manoloaterol/18650_Manager/schematics/18650_Manager_schematic.pdf

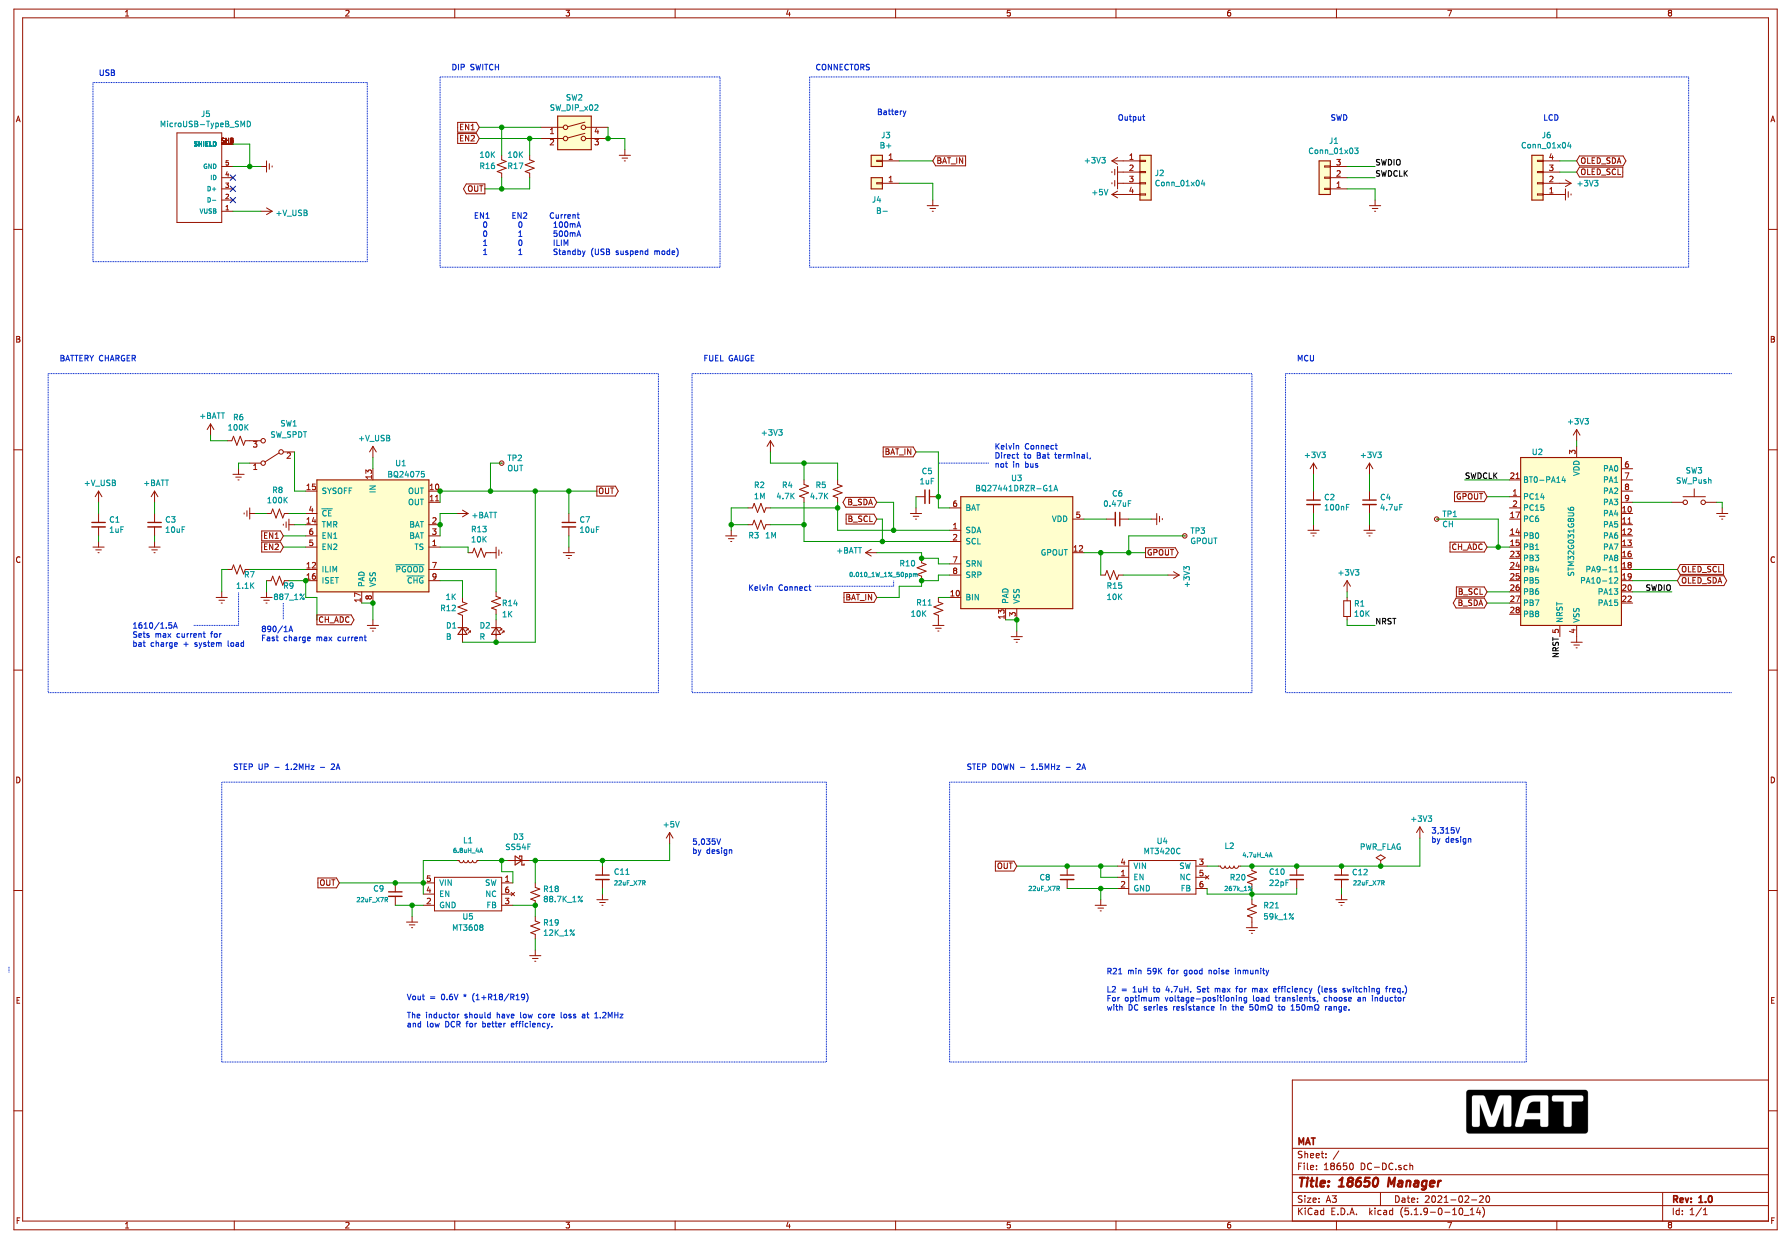
[picture p2: page 1]
