manoloaterol/18650_Manager/(threads)

Thread 1 (2023-07-21):

not an issue but a question i2c api

clecle253, 2023-07-21:
helo i order two of this board and i have a question i would like to use them to power up an esp32 or esp866 for domotic (home assistant) and i would get value display on screen on i2c to be able to serve this data on my dash board. is there an easy way to do that ?

manoloaterol, 2023-07-21:
Hi @clecle253. Thank you very much for your order.

The board and firmware are not ready to do what you want out-of-the-box, but you can make some modifications to achieve it. Not too easy way, but definitely possible.

On PCB, the only exposed MCU pins are the ones used to the display, so you can use them to communicate with ESP with the same protocol (I2C).

These are the steps to follow:

- Connect ESP MCU to the SCL and SDA pins reserved for the display. (if ESP is powered by the 18650_manager, both grounds are already common)
- ESP must be configured as I2C slave. If you are using ESP-IDF you can find a sample [here](https://github.com/espressif/esp-idf/tree/master/examples/peripherals/i2c/i2c_self_test). If you are programming in Arduino I'm pretty sure you can find some samples somewhere.
- Modify the 18650_Manager firmware to make a second I2C communication to send the data to your ESP.
- Send data to Home Assistant. Here you can create a custom sensor for ESPHome like [this](https://community.home-assistant.io/t/esphome-custom-sensor-bq27441/483177), or using the MQTT protocol.

Hope it helps.

clecle253, 2023-07-22:
Ok i'm not familiar with the ide and framework you use but il Will try to implement this feature cleanly if it work Well i Will make à pull request
