manoloaterol/18650_Manager/src/18650_DC-DC/Src/main.c

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
/* Includes ------------------------------------------------------------------*/
#include "main.h"

/* USER CODE BEGIN Includes */
#include "bq27441/bq27441-g1.h"
#include "bq27441/i2c.h"

#include "ssd1306/ssd1306.h"
#include <stdio.h>
/* USER CODE END Includes */

ADC_HandleTypeDef hadc1;

I2C_HandleTypeDef hi2c1;
I2C_HandleTypeDef hi2c2;

/* USER CODE BEGIN PV */
bq27441_g1_t bq27441_g1;

uint8_t mode = 1;      // visualization mode
uint32_t lastTick = 0; // used to avoid button bounce effect
/* USER CODE END PV */

void SystemClock_Config(void);
static void MX_GPIO_Init(void);
static void MX_ADC1_Init(void);
static void MX_I2C1_Init(void);
static void MX_I2C2_Init(void);
/* USER CODE BEGIN PFP */
void showVoltage();
void showHeader();
void showAverageCurrent();
void showAveragePower();
void showSOH();
void showDesignCapacity();
void showFullChargeCapacity();
void showRemainingCapacity();
/* USER CODE END PFP */

/**
  * @brief  The application entry point.
  * @retval int
  */
int main(void)
{
  /* MCU Configuration--------------------------------------------------------*/

  /* Reset of all peripherals, Initializes the Flash interface and the Systick. */
  HAL_Init();

  /* Configure the system clock */
  SystemClock_Config();

  /* Initialize all configured peripherals */
  MX_GPIO_Init();
  MX_ADC1_Init();
  MX_I2C1_Init();
  MX_I2C2_Init();
  /* USER CODE BEGIN 2 */

  HAL_Delay(100);
  SSD1306_Init();
  // HAL_Delay(100);
  SSD1306_ON();
  SSD1306_Fill(0);
  SSD1306_UpdateScreen();

  bq27441_g1.Read = i2cReadRegister;
  bq27441_g1.Write = i2cWriteRegister;


  char msg[] = "bat config ...";
  SSD1306_Fill(0);
  SSD1306_GotoXY(0, 10);
  SSD1306_Puts(msg, &Font_7x10, 1);
  SSD1306_UpdateScreen();

  BQ27441_G1_Setup(&bq27441_g1, 3400, 3200);


  /* USER CODE END 2 */

  /* Infinite loop */
  /* USER CODE BEGIN WHILE */
  while (1)
  {


    // Execute visualization mode
    SSD1306_Fill(0);
    showHeader();
    switch (mode)
    {
    case 1:
      showAverageCurrent();
      break;
    case 2:
      showAveragePower();
      break;
    case 3:
      showRemainingCapacity();
      break;
    case 4:
      showVoltage();
      break;
    case 5:
      showDesignCapacity();
      break;
    case 6:
      showFullChargeCapacity();
      break;
    case 7:
      showSOH();
      break;
    default:
      break;
    }

    SSD1306_UpdateScreen();

    HAL_Delay(500);
    /* USER CODE END WHILE */

    /* USER CODE BEGIN 3 */
  }
  /* USER CODE END 3 */
}

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
/* USER CODE BEGIN 4 */
void HAL_GPIO_EXTI_Falling_Callback(uint16_t GPIO_Pin)
{
  if (GPIO_Pin == GPIO_PIN_3)
  {

    // Check clock ticks between interrupts
    // to avoid bounce effect
    uint32_t tick = HAL_GetTick();
    uint32_t diff = tick - lastTick;
    if (diff > 300)
    {

      mode++;
      if (mode > 7)
      {
        mode = 1;
      }
    }

    lastTick = tick;
  }
}

void showVoltage()
{
  uint16_t voltage = 0;
  voltage = BQ27441_G1_GetVoltage(&bq27441_g1);

  char tmp[20];
  sprintf(tmp, "V: %d mV", voltage);
  SSD1306_GotoXY(0, 13);
  SSD1306_Puts(tmp, &Font_11x18, 1);
}
void showHeader()
{
  uint16_t soc = 0;
  float temp = 0;
  soc = BQ27441_G1_GetStateOfChargeUnfiltered(&bq27441_g1);
  temp = BQ27441_G1_GetTemperature(&bq27441_g1);

  char temperature[9];
  sprintf(temperature, "%.1f ^C", temp);
  SSD1306_GotoXY(0, 0);
  SSD1306_Puts(temperature, &Font_7x10, 1);

  char remain[4];
  sprintf(remain, "%d%%", soc);
  SSD1306_GotoXY(98, 0);
  SSD1306_Puts(remain, &Font_7x10, 1);
}
void showAverageCurrent()
{
  int16_t avgCur = 0;
  avgCur = BQ27441_G1_GetAverageCurrent(&bq27441_g1);

  char tmp[30];
  sprintf(tmp, "C:%d mA", avgCur);
  SSD1306_GotoXY(0, 13);
  SSD1306_Puts(tmp, &Font_11x18, 1);
}

void showAveragePower()
{

  int16_t avgPwr = 0;
  avgPwr = BQ27441_G1_GetAveragePower(&bq27441_g1);

  char tmp[30];
  sprintf(tmp, "P:%d mW", avgPwr);
  SSD1306_GotoXY(0, 13);
  SSD1306_Puts(tmp, &Font_11x18, 1);
}

void showSOH()
{
  uint8_t soh = 0;
  i2c_read(0x55, 0x20, &soh, 1);

  char tmp[20];
  sprintf(tmp, "HLTH: %d%%", soh);
  SSD1306_GotoXY(0, 13);
  SSD1306_Puts(tmp, &Font_11x18, 1);
}
void showDesignCapacity()
{
  uint16_t descap = 0;
  descap = BQ27441_G1_GetDesignCapacity(&bq27441_g1);

  char tmp[20];
  sprintf(tmp, "D.C:%d mA", descap);
  SSD1306_GotoXY(0, 13);
  SSD1306_Puts(tmp, &Font_11x18, 1);
}
void showFullChargeCapacity()
{
  uint16_t fullcap = 0;
  fullcap = BQ27441_G1_GetFullChargeCapacityUnfiltered(&bq27441_g1);

  char tmp[20];
  sprintf(tmp, "F.C:%d mA", fullcap);
  SSD1306_GotoXY(0, 13);
  SSD1306_Puts(tmp, &Font_11x18, 1);
}
void showRemainingCapacity()
{
  uint16_t remcap = 0;
  remcap = BQ27441_G1_GetRemainingCapacityUnfiltered(&bq27441_g1);

  char tmp[20];
  sprintf(tmp, "R.C:%d mA", remcap);
  SSD1306_GotoXY(0, 13);
  SSD1306_Puts(tmp, &Font_11x18, 1);
}
/* USER CODE END 4 */
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
