manoloaterol/18650_Manager/src/18650_DC-DC/18650_DC-DC.ioc

Mcu.UserName=STM32G031G8Ux
PA13.Signal=SYS_SWDIO
PA14-BOOT0.Signal=SYS_SWCLK
PA3.Signal=GPXTI3
PB1.Signal=ADC1_IN9
PB6.Signal=I2C1_SCL
PB7.Signal=I2C1_SDA
